jvgiordano/OSSMM-Version-1/README.md

# OSSMM Version 1
Open-Source Sleep Monitor and Modulator

Check out the Github Live Page here:
https://jvgiordano.github.io/OSSMM-Version-1/
