jvgiordano/OSSMM-Version-1/docs/_pages/home.md

---
layout: splash
permalink: /
date: 2025-05-17T04:20:20+01:00
header:
  overlay_image: /media/home/system-ai.JPG
  actions:
    - label: "<i class='fas fa-download'></i> Start Building!"
      url: "/getting-started/"
excerpt: >
  An **O**pen-**S**ource **S**leep **M**onitor and **M**odulator <br />
  <small><a href="https://github.com/jvgiordano/OSSMM">Latest release v1.0.4</a></small>

intro:
  - excerpt: "OSSMM breaks down the cost barriers in sleep research by providing researchers and enthusiasts with an affordable, accurate, and fully open-source platform for both sleep monitoring and modulation experiments. Build your own system for under €60."

feature_row:
  - image_path: /media/home/quick-intro.jpg
    alt: "OSSMM headband overview showing key components"
    title: "Quick Intro"
    excerpt: "New to OSSMM? Get a rapid overview of what it is, how it works, and why it matters for sleep research."
    url: "/quick-intro/"
    btn_class: "btn--primary"
    btn_label: "Get Started"
    
  - image_path: /media/home/getting-started.jpg
    alt: "Detailed build guide and component overview"
    title: "Complete Build Guide"
    excerpt: "Deep dive into OSSMM's capabilities, construction process, and cost breakdown. Everything you need to build your own system."
    url: "/getting-started/"
    btn_class: "btn--primary"
    btn_label: "Start Building"
    
  - image_path: /media/home/performance.jpg
    alt: "Performance assessment"
    title: "Sleep Staging Performance"
    excerpt: "*Currently under Assessment for 4-Stage Sleep Classification*"
    url: "/performance/"
    btn_class: "btn--primary"
    btn_label: "Learn more" 

---

{% include feature_row id="intro" type="center" %}

{% include feature_row %}

---
*Current Version: V1.0.4*
