jvgiordano/OSSMM-Version-1/docs/media/home/quick-backup.jpg

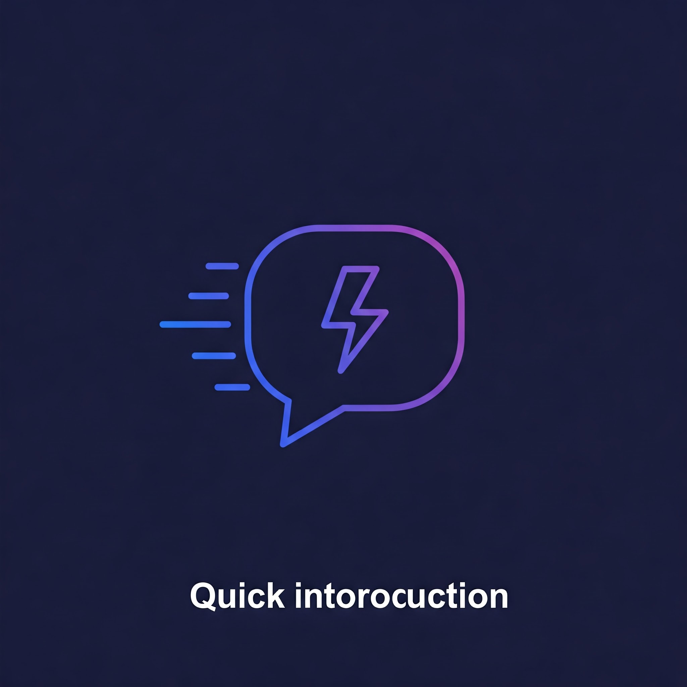
docs/media/home/quick-backup.jpg
