jvgiordano/OSSMM-Version-1/docs/media/home/quick-intro-2.jpg

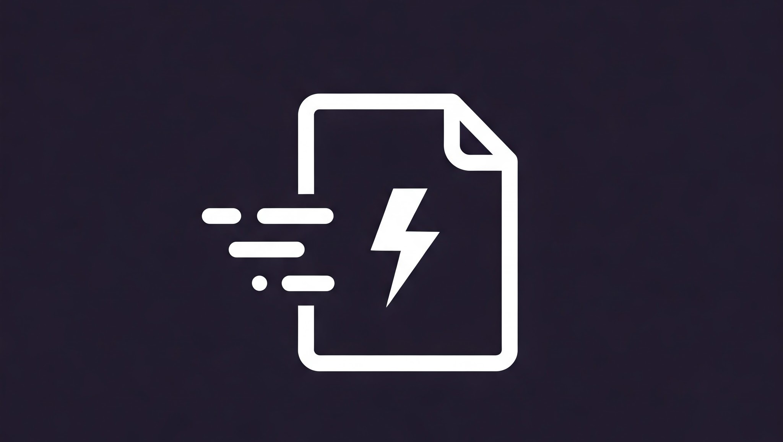
docs/media/home/quick-intro-2.jpg
