jvgiordano/OSSMM-Version-1/docs/media/home/quick-intro.jpg

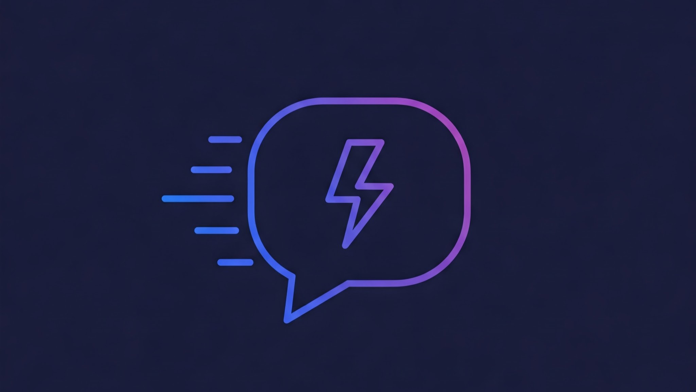
docs/media/home/quick-intro.jpg
