jvgiordano/OSSMM-Version-1/docs/media/home/safety-data.jpg

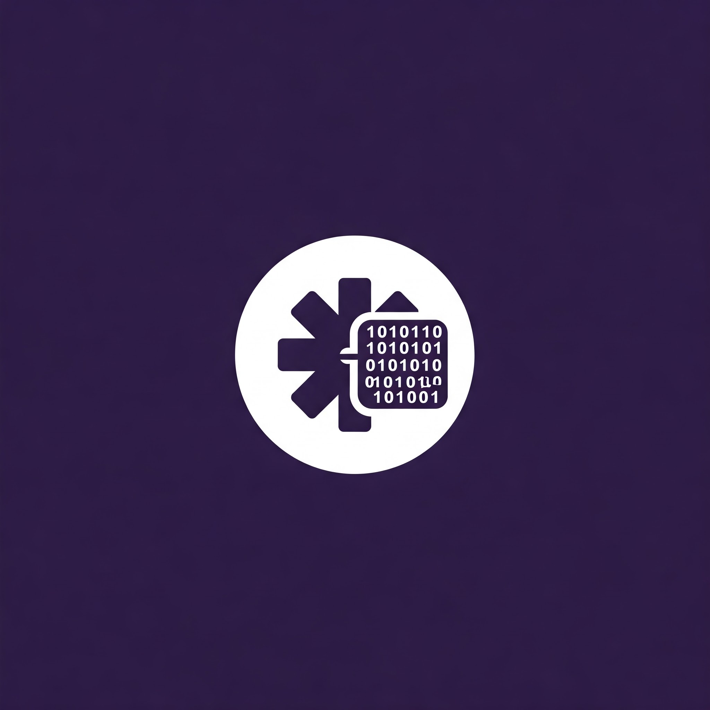
docs/media/home/safety-data.jpg
