jvgiordano/OSSMM-Version-1/docs/media/home/Started-backup.jpg

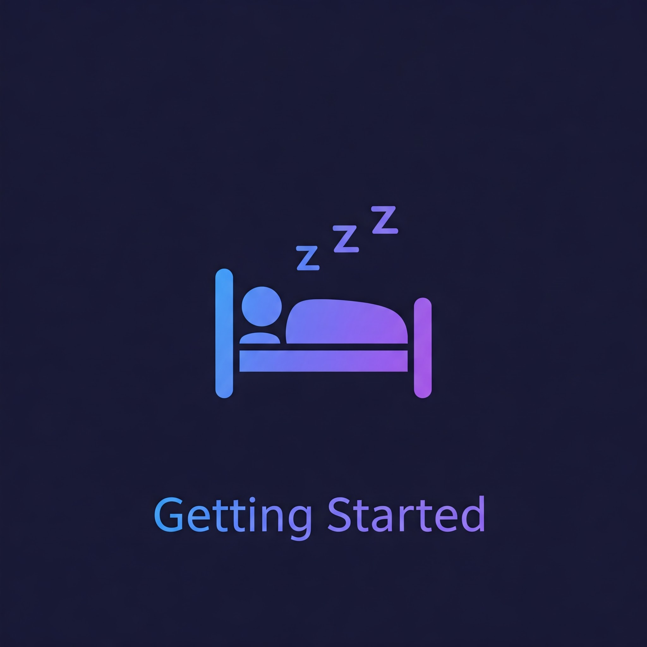
docs/media/home/Started-backup.jpg
