jvgiordano/OSSMM-Version-1/docs/media/home/system-ai-backup.jpg

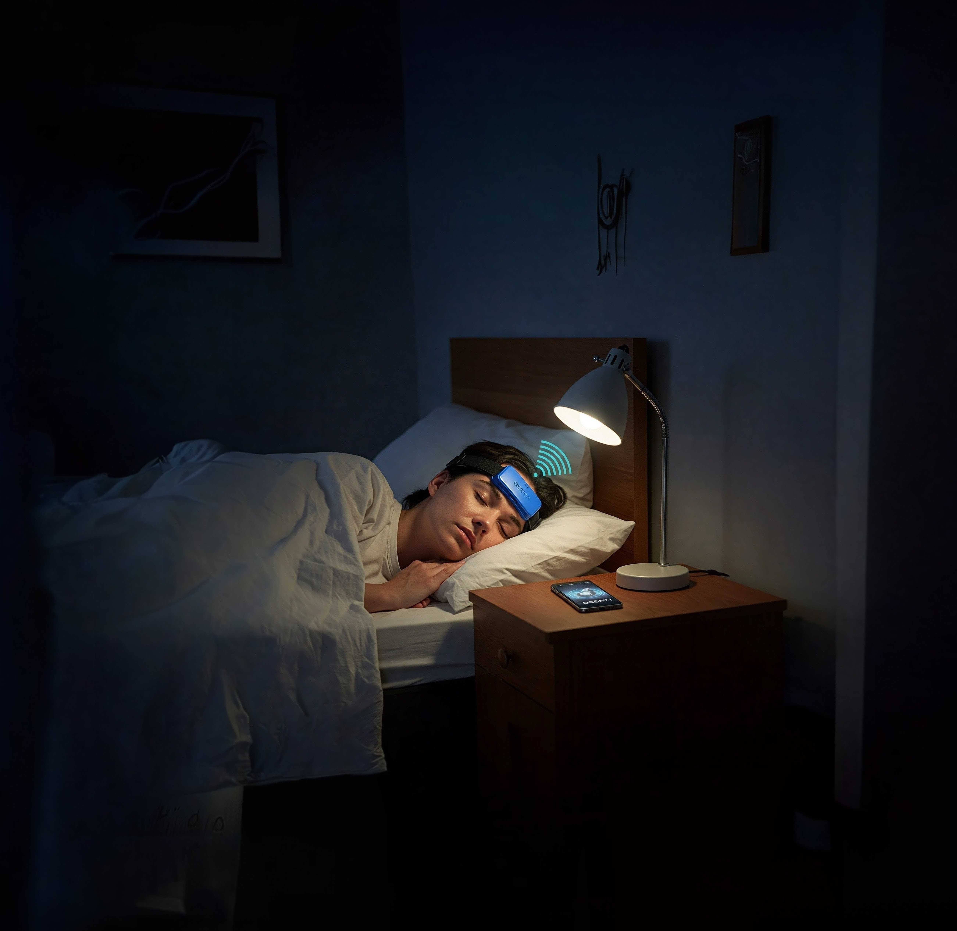
docs/media/home/system-ai-backup.jpg
