jvgiordano/OSSMM-Version-1/docs/media/software/downloads-folder.png

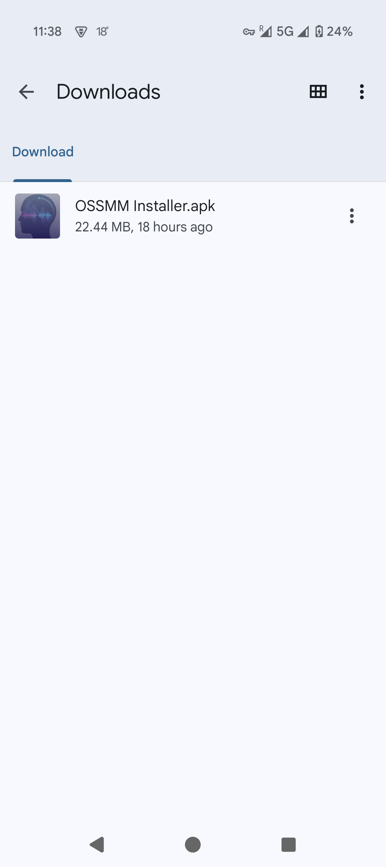
docs/media/software/downloads-folder.png
