jvgiordano/OSSMM-Version-1/docs/media/software/open-page.jpg

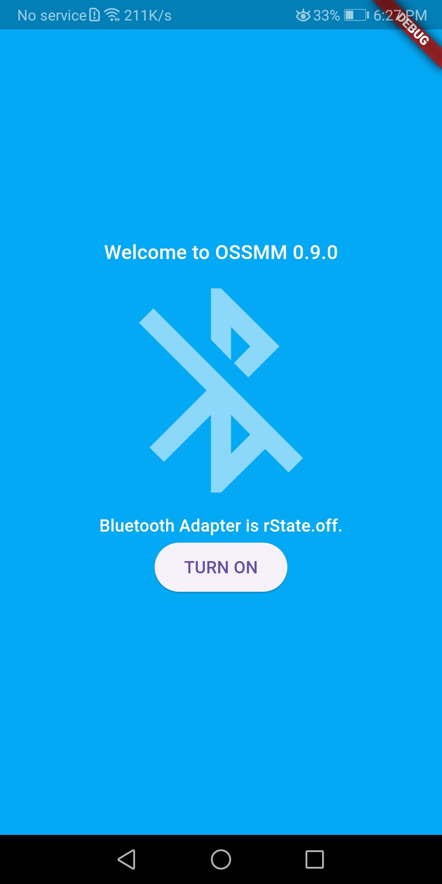
docs/media/software/open-page.jpg
