jvgiordano/OSSMM-Version-1/docs/media/software/storage-page.jpg

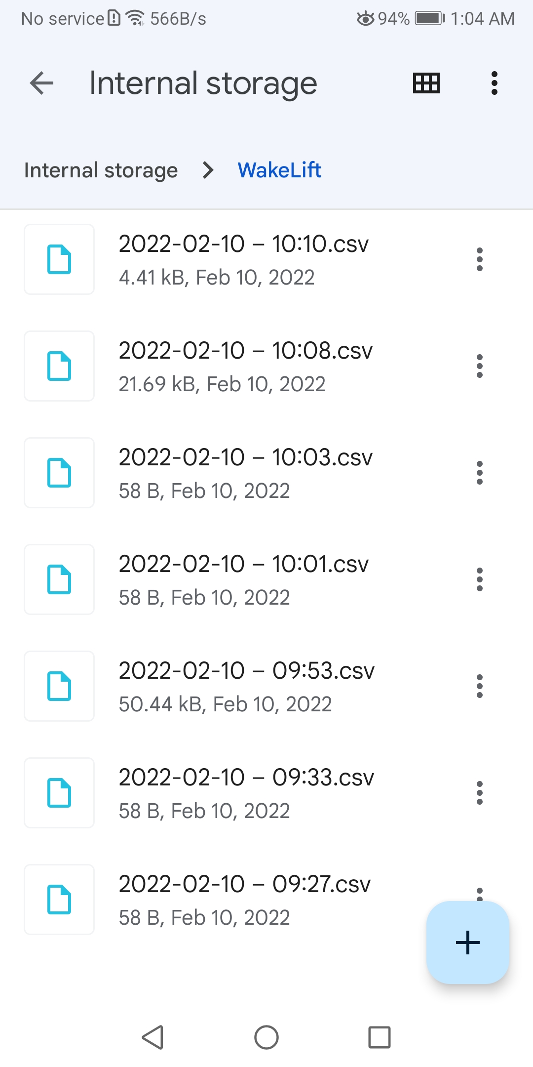
docs/media/software/storage-page.jpg
