jvgiordano/OSSMM-Version-1/docs/media/getting-started/cad_parts_annotated.jpg

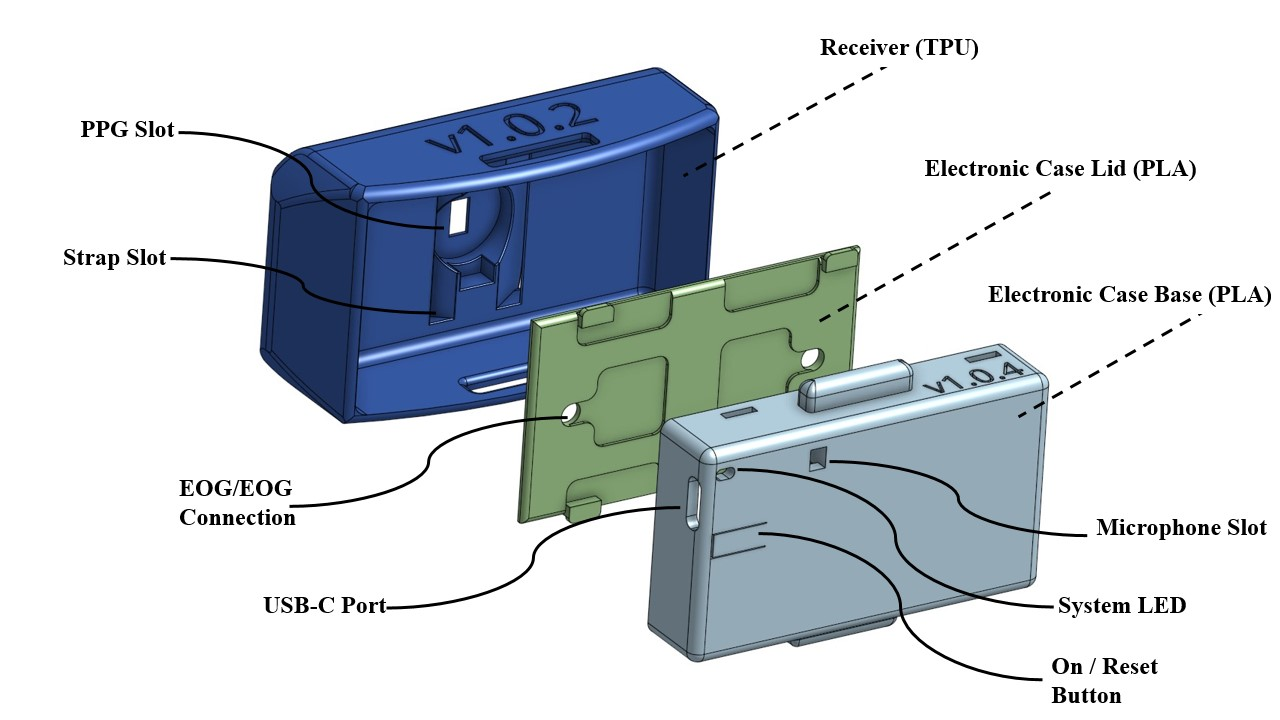
docs/media/getting-started/cad_parts_annotated.jpg
