jvgiordano/OSSMM-Version-1/docs/media/printables/cad-parts - Copy.jpg

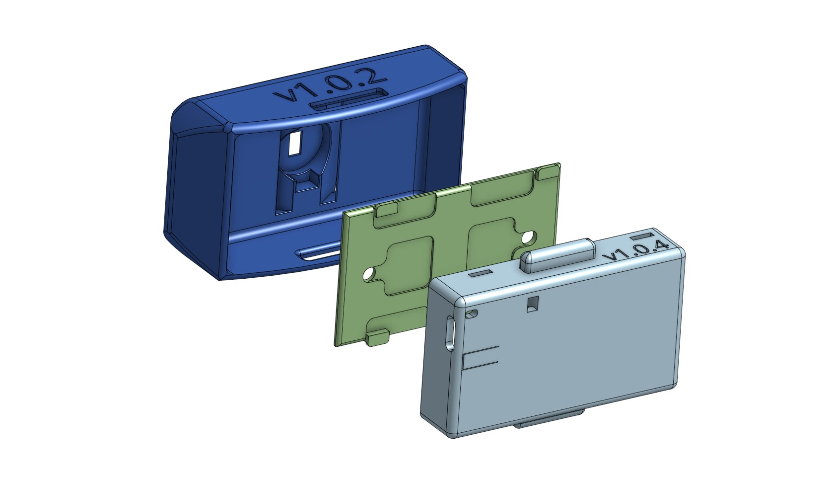
docs/media/printables/cad-parts - Copy.jpg
