jvgiordano/OSSMM-Version-1/OSSMM - V1.0.4 Printables/STL Files/v1.0.4 - Electronic Case (Bottom + Lid).stl

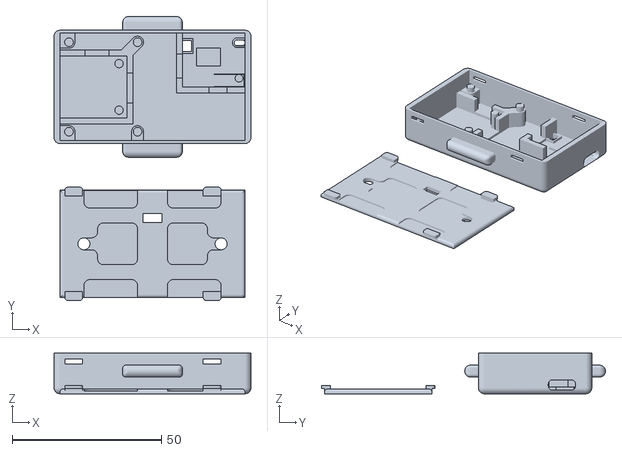
[picture p42: CAD file, 2025-04-25]
OSSMM - V1.0.4 Printables/STL Files/v1.0.4 - Electronic Case (Bottom + Lid).stl
66.0 x 95.2 x 13.6
