jvgiordano/OSSMM-Version-1/OSSMM - V1.0.4 Printables/STL Files/v1.0.2 - Receiver.stl

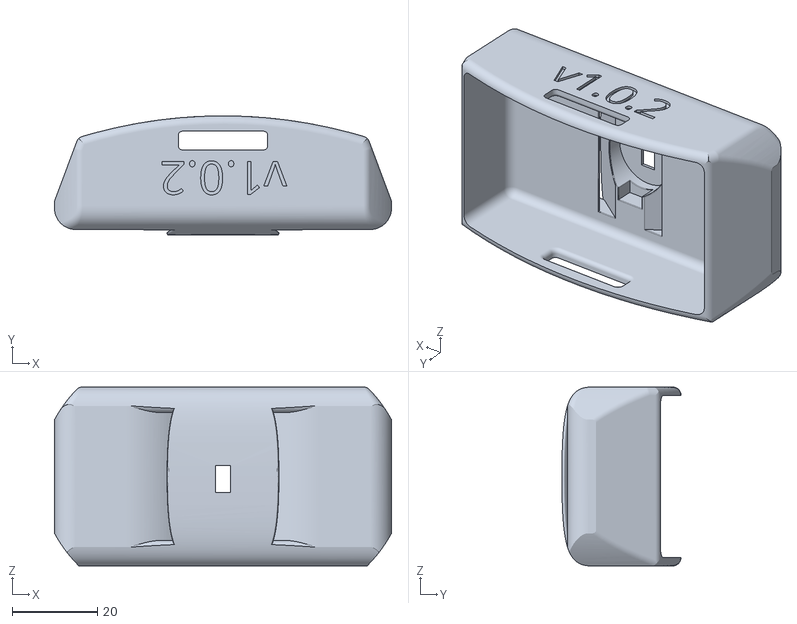
[picture p43: CAD file, 2025-04-25]
OSSMM - V1.0.4 Printables/STL Files/v1.0.2 - Receiver.stl
79.1 x 28.0 x 42.0
