jvgiordano/OSSMM-Version-1/OSSMM - V1.0.4 Printables/Link to OnShape.txt

Link to V1.0.4 OSSMM

https://cad.onshape.com/documents/9770a63668febc8c28355357/w/080415be9bd2ce05fb700580/e/b2014883be9420c43d264f39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
