jvgiordano/OSSMM-Version-1/docs/media/home/getting-started-2.jpg

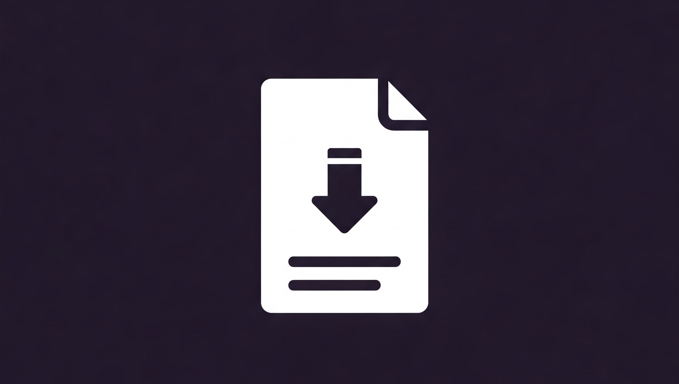
docs/media/home/getting-started-2.jpg
