jvgiordano/OSSMM-Version-1/docs/media/home/getting-started.jpg

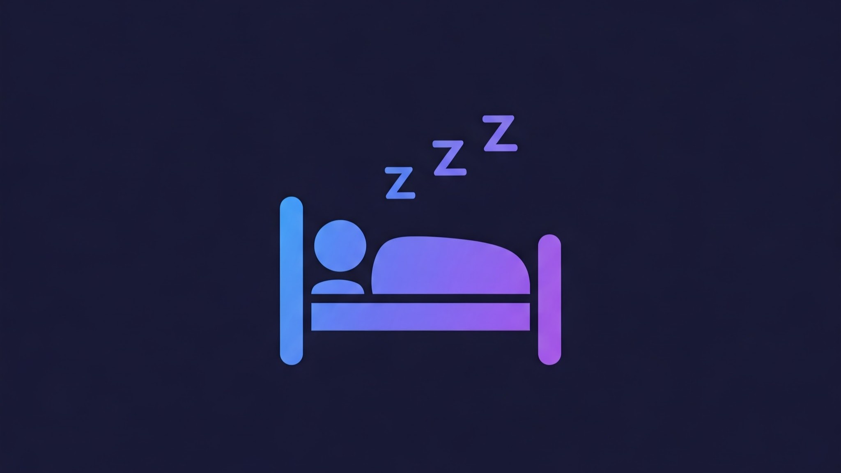
docs/media/home/getting-started.jpg
