jvgiordano/OSSMM-Version-1/docs/_pages/performance.md

---
title: "Performance - Sleep Staging Accuracy"
permalink: /performance/
date: "2025-04-23"
classes: wide
sidebar:
  nav: "pages_sidebar_nav"
---

# Sleep Staging Accuracy

*OSSMM is currently under technical validation for 4-stage sleep classification accuracy.*

If you are interested and would like to contribute to this research, let us know!
