jvgiordano/OSSMM-Version-1/docs/media/home/performance-backup.jpg

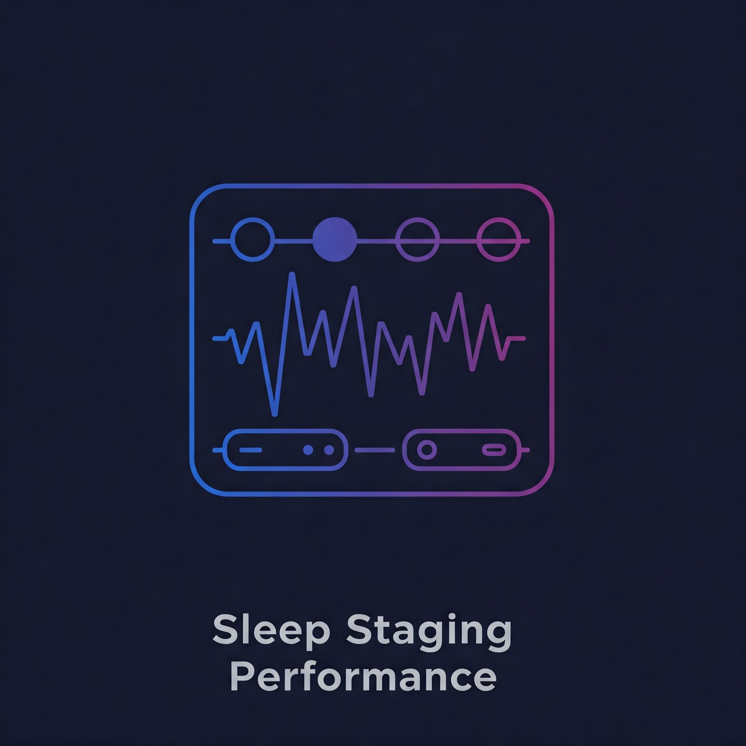
docs/media/home/performance-backup.jpg
