jvgiordano/OSSMM-Version-1/docs/media/home/performance.jpg

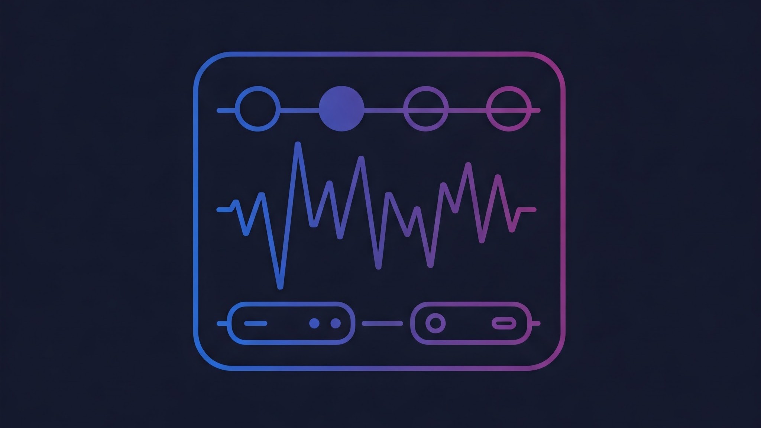
docs/media/home/performance.jpg
