jvgiordano/OSSMM-Version-1/(commit log)

2025-04-17 Completed first draft of index.md, and electronics-assembly.md
2025-04-17 Added 3.5mm JackRemoval gif, updated the electronics-assembly.md
2025-04-18 Updated images with arrowed info, updated electronics-assembly and index. Changed step 4 and 5 for overall assembly. Software is now last.
2025-04-18 Attempted fix of electronics-assembly page
2025-04-18 Updates to readability of electronics-assembly
2025-04-18 Rewrote the electronics-assembly for clarity. Improved some images with arrows and descrptions.
2025-04-18 Attempting to fix last broke image in electronics-assembly
2025-04-22 Switched to wide format for pages
2025-04-23 Image fix attempt #1 electronics assembly
2025-04-23 Added blank pages for printables, software, final-checks. Also attempt to add the navigation with children headers to all relevant pages.
2025-04-24 Additional Button for Sleep Stage front page
2025-04-25 Started Printables Section, Included all Printable images, Uploaded STL files, renamed folders
    [v1.0.2 - Receiver.stl, v1.0.4 - Electronic Case (Bottom + Lid).stl]
2025-04-25 Fixed cad-parts jpg
2025-04-25 Half written printables
2025-04-26 Images for Arduino IDE install and MCU code
2025-05-01 Final-Assembly -> Major Parts Assembly, Made Side Navigation less frightening
2025-05-01 Implemented encryption for data files
    As soon as recording is complete, CSV files is zipped and password protected. Password is generated when the app is installed on the Android device and visible on the application.
2025-05-06 Fixed Security and UI issues for Android 15 app, Fixed homescreen background, updated pairing in MCU code
    [OSSMM_XiaoSense_V1.0.2.ino]
2025-05-09 Increased Vibration motor time (MCU), Changed defaults on app dashboard, removed unneeded permissions too
    [OSSMM_XiaoSense_V1.0.2.ino]
2025-05-12 Updated app to deal with Bluetooth Exceptions, Added in forced requirement for location (otherwise BLE won't work).
    [OSSMM_XiaoSense_V1.0.2.ino]
2025-05-14 Updated on resistance levels for heart rate straps
2025-05-14 Added several photos for assembly
2025-05-14 Updated photo, updated assembly
2025-05-14 Fixes to images and final assembly
2025-05-15 Added last-strap gif
2025-05-15 Added Serial search time for MCU to 10 seconds, shortened live data plotting to 15 seconds
    [OSSMM_XiaoSense_V1.0.2.ino]
2025-05-16 Improvements to electronics-assembly and typo checking
2025-05-16 Re-edit of final-assembly
2025-05-16 Final edits(?) for final-assembly
2025-05-17 Switched to <figure> in final-checks
